kevinisabelle/litdlm01/Images/20180725_194641.jpg

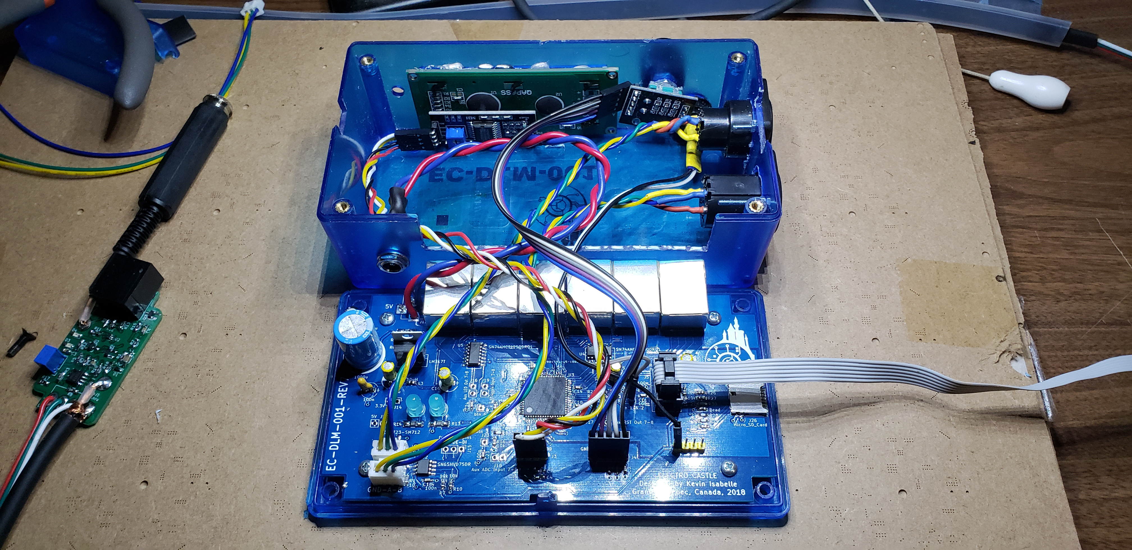
Images/20180725_194641.jpg
