kevinisabelle/litdlm01/Images/20180725_194719.jpg

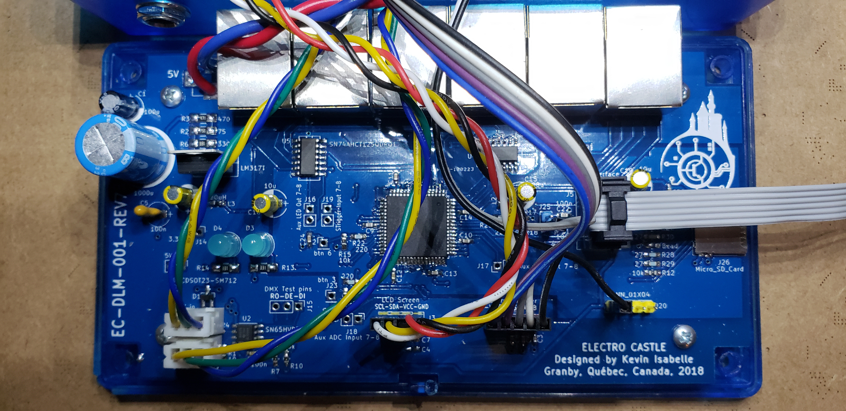
Images/20180725_194719.jpg
