kevinisabelle/litdlm01/Images/20180725_194620.jpg

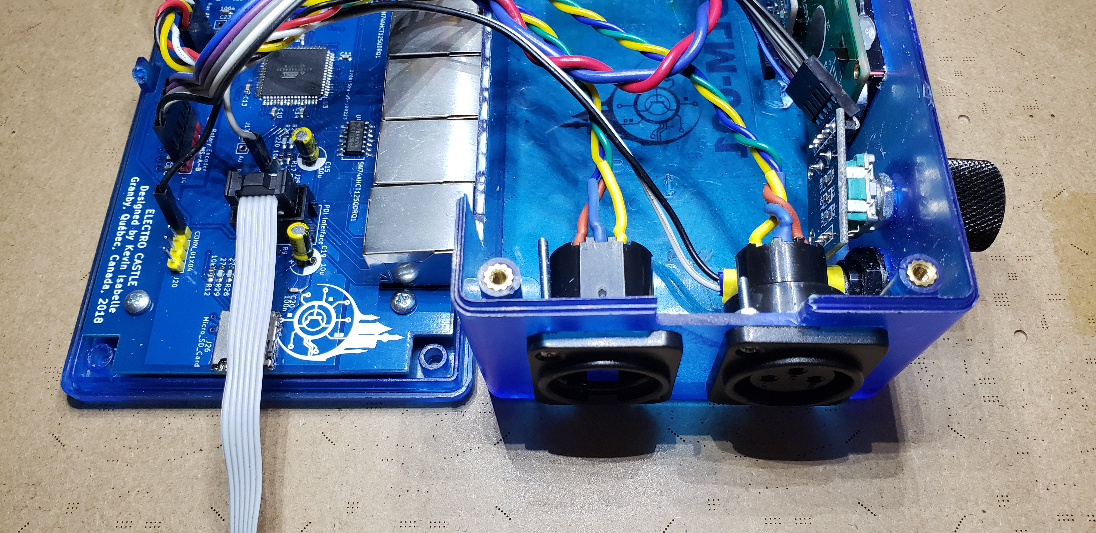
Images/20180725_194620.jpg
