kevinisabelle/litdlm01/Images/20180725_194701.jpg

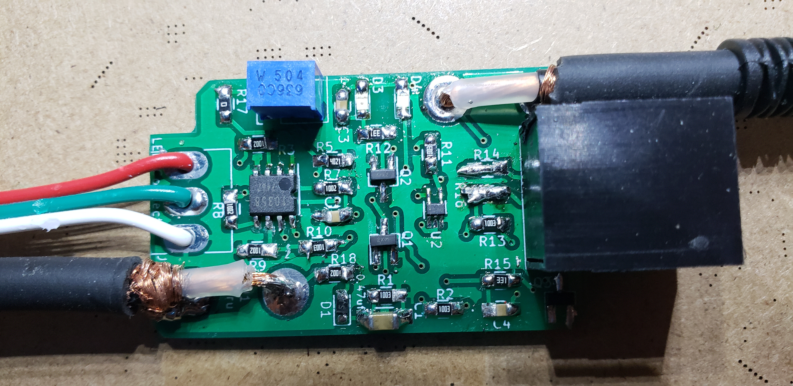
Images/20180725_194701.jpg
