kevinisabelle/litdlm01/PCBs/EC-DLM-TR03/ec-dlm-tr03-REV7.1-Front.jpg

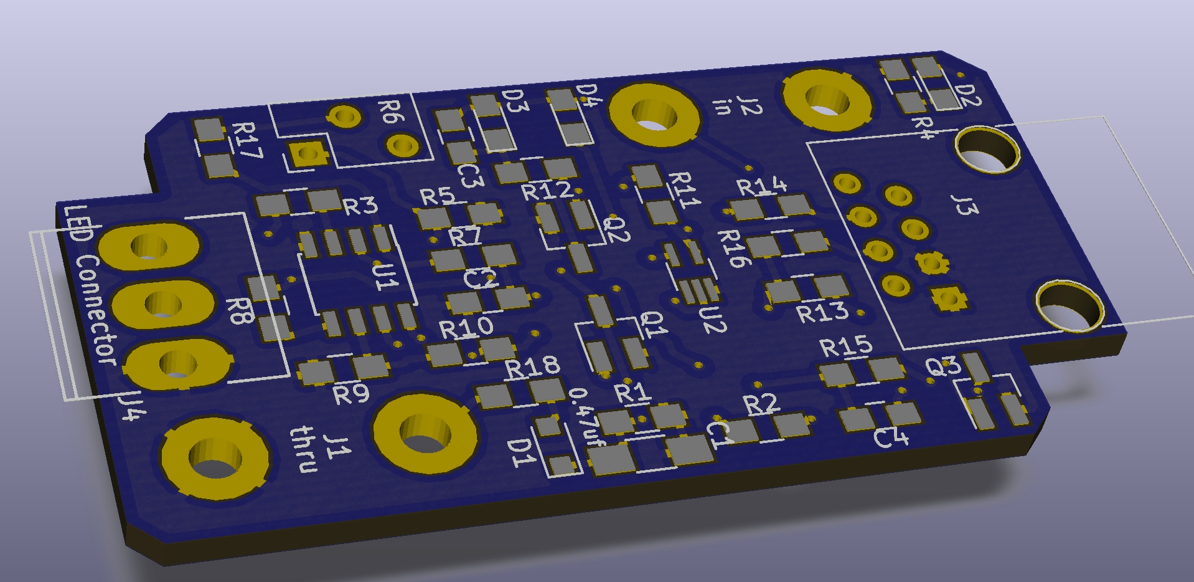
PCBs/EC-DLM-TR03/ec-dlm-tr03-REV7.1-Front.jpg
