kevinisabelle/litdlm01/PCBs/EC-DLM-TR03/ec-dlm-tr03-rev7.1-BOM.xls

 | Ref | Value | Footprint
3 | C2 | 104 | Capacitors_SMD:C_0805_HandSoldering
 | C3 | 104 | Capacitors_SMD:C_0805_HandSoldering
 | C4 | 104 | Capacitors_SMD:C_0805_HandSoldering
1 | C1 | 0.47uf | Capacitors_SMD:C_1206_HandSoldering
1 | D1 | 1N5817 | Diodes_SMD:D_SOD-323_HandSoldering
1 | U1 | ADA4075 | Housings_SOIC:SOIC-8_3.9x4.9mm_Pitch1.27mm
1 | D2 | LED (vert à l'intérieur) | LEDs:LED_0805_HandSoldering
1 | D3 | LED (vert à l'intérieur) | LEDs:LED_0805_HandSoldering
1 | D4 | LED (vert à l'intérieur) | LEDs:LED_0805_HandSoldering
3 | R14 | 0 | Resistors_SMD:R_0805_HandSoldering
 | R16 | 0 | Resistors_SMD:R_0805_HandSoldering
6 | R17 | 100k | Resistors_SMD:R_0805_HandSoldering
 | R1 | 100k | Resistors_SMD:R_0805_HandSoldering
 | R10 | 100k | Resistors_SMD:R_0805_HandSoldering
 | R11 | 100k | Resistors_SMD:R_0805_HandSoldering
 | R13 | 100k | Resistors_SMD:R_0805_HandSoldering
 | R2 | 100k | Resistors_SMD:R_0805_HandSoldering
4 | R18 | 10k | Resistors_SMD:R_0805_HandSoldering
 | R7 | 10k | Resistors_SMD:R_0805_HandSoldering
 | R8 | 10k | Resistors_SMD:R_0805_HandSoldering
 | R9 | 10k | Resistors_SMD:R_0805_HandSoldering
4 | R12 | 330 | Resistors_SMD:R_0805_HandSoldering
 | R15 | 330 | Resistors_SMD:R_0805_HandSoldering
 | R3 | 330 | Resistors_SMD:R_0805_HandSoldering
 | R4 | 330 | Resistors_SMD:R_0805_HandSoldering
1 | R5 | 4k | Resistors_SMD:R_0805_HandSoldering
3 | Q1 | 2N4401 | TO_SOT_Packages_SMD:SOT-23_Handsoldering
 | Q2 | 2N4401 | TO_SOT_Packages_SMD:SOT-23_Handsoldering
 | Q3 | 2N4401 | TO_SOT_Packages_SMD:SOT-23_Handsoldering
1 | U2 | SN74LVC1G17-Q1 | TO_SOT_Packages_SMD:SOT-353_SC-70-5_Handsoldering
 | J2 | in | Wire_Connections_Bridges:WireConnection_2.50mmDrill
 | J1 | thru | Wire_Connections_Bridges:WireConnection_2.50mmDrill
 | J3 | RJ45 | Connectors:RJ45_8
 | R6 | 500k | ec-dlm:TrimPot_Straight_2x03_Pitch2.54mm
 | J4 | LED Connector | 3 wires with connector
