kevinisabelle/litdlm01/PCBs/EC-DLM-TR04/ec-dlm-tr04-bom.ods

 | Reference | Value | Footprint | Datasheet
3 | C4 | 0.1uf | Capacitors_SMD:C_0805_HandSoldering
 | C6 | 0.1uf | Capacitors_SMD:C_0805_HandSoldering
 | C7 | 0.1uf | Capacitors_SMD:C_0805_HandSoldering
3 | C2 | 100uf | Capacitors_THT:CP_Radial_D4.0mm_P1.50mm
 | C3 | 100uf | Capacitors_THT:CP_Radial_D4.0mm_P1.50mm
 | C5 | 100uf | Capacitors_THT:CP_Radial_D4.0mm_P1.50mm
1 | C1 | 330uf | Capacitors_THT:CP_Radial_D4.0mm_P1.50mm
1 | J2 | RJ45 | Connectors:RJ45_8
7 | D1 | 1N4148 | Diodes_SMD:D_SOD-123
 | D6 | 1N4148 | Diodes_SMD:D_SOD-123
 | D8 | 1N4148 | Diodes_SMD:D_SOD-123
 | D2 | 1N4148 | Diodes_SMD:D_SOD-123
 | D3 | 1N4148 | Diodes_SMD:D_SOD-123
 | D4 | 1N4148 | Diodes_SMD:D_SOD-123
 | D5 | 1N4148 | Diodes_SMD:D_SOD-123
2 | D7 | BZX79C3V3 | Diodes_THT:D_DO-35_SOD27_P2.54mm_Vertical_AnodeUp
 | D9 | BZX79C3V3 | Diodes_THT:D_DO-35_SOD27_P2.54mm_Vertical_AnodeUp
1 | RV1 | 10k | Potentiometers:Potentiometer_WirePads_Small
1 | RV2 | 5k | Potentiometers:Potentiometer_WirePads_Small
1 | R17 | 100k | Resistors_SMD:R_0603_HandSoldering
5 | R12 | 10k | Resistors_SMD:R_0603_HandSoldering
 | R16 | 10k | Resistors_SMD:R_0603_HandSoldering
 | R5 | 10k | Resistors_SMD:R_0603_HandSoldering
 | R6 | 10k | Resistors_SMD:R_0603_HandSoldering
 | R7 | 10k | Resistors_SMD:R_0603_HandSoldering
1 | R1 | 10m | Resistors_SMD:R_0603_HandSoldering
2 | R13 | 15k | Resistors_SMD:R_0603_HandSoldering
 | R3 | 15k | Resistors_SMD:R_0603_HandSoldering
1 | R2 | 1m | Resistors_SMD:R_0603_HandSoldering
2 | R10 | 20k | Resistors_SMD:R_0603_HandSoldering
 | R8 | 20k | Resistors_SMD:R_0603_HandSoldering
1 | R11 | 3.9k | Resistors_SMD:R_0603_HandSoldering
1 | R4 | 6.6k | Resistors_SMD:R_0603_HandSoldering
1 | R15 | 600 | Resistors_SMD:R_0603_HandSoldering
1 | R14 | 8k | Resistors_SMD:R_0603_HandSoldering
1 | R9 | 9k | Resistors_SMD:R_0603_HandSoldering
2 | U1 | TL084 | SMD_Packages:SOIC-14_N
 | U3 | TL084 | SMD_Packages:SOIC-14_N
 | J3 | LED Connector | Sockets_MOLEX_KK-System:Socket_MOLEX-KK-RM3-96mm_Lock_3pin_straight
 | J1 | input | Wire_Connections_Bridges:WireConnection_2.50mmDrill
