kevinisabelle/litdlm01/PCBs/EC-DLM-001-Rev9/kicadProject/EC-DLM-001-Rev9-bom.csv

Reference | Value | Footprint | Datasheet
U3 | ATXMEGA64A3U-AU | Housings_QFP:TQFP-64_14x14mm_Pitch0.8mm
C9 | 100n | Capacitors_SMD:C_0805_HandSoldering
C10 | 100n | Capacitors_SMD:C_0805_HandSoldering
C11 | 100n | Capacitors_SMD:C_0805_HandSoldering
C12 | 100n | Capacitors_SMD:C_0805_HandSoldering
C13 | 100n | Capacitors_SMD:C_0805_HandSoldering
C14 | 100n | Capacitors_SMD:C_0805_HandSoldering
J9 | RJ45 | Connectors:RJ45_8
J11 | RJ45 | Connectors:RJ45_8
J8 | RJ45 | Connectors:RJ45_8
J10 | RJ45 | Connectors:RJ45_8
L2 | Fer Bead | Inductors_SMD:L_0805_HandSoldering
U2 | SN65HVD75DR | Housings_SOIC:SOIC-8_3.9x4.9mm_Pitch1.27mm
U1 | LM317T | TO_SOT_Packages_THT:TO-220-3_Vertical
C1 | 100u | Capacitors_THT:CP_Radial_D6.3mm_P2.50mm
C2 | 10u-tant | Capacitors_THT:CP_Radial_D6.3mm_P2.50mm
C5 | 100n | Capacitors_THT:CP_Radial_Tantal_D5.5mm_P2.50mm
R2 | 75 | Resistors_SMD:R_1206_HandSoldering
R3 | 470 | Resistors_SMD:R_1206_HandSoldering
R6 | 330 | Resistors_SMD:R_1206_HandSoldering
J5 | PDI Interface | Connectors:IDC_Header_Straight_6pins
L3 | 10uH | Inductors_SMD:L_0805_HandSoldering
C16 | 10u-tant | Capacitors_THT:CP_Radial_D6.3mm_P2.50mm
C15 | 10u | Capacitors_THT:CP_Radial_D6.3mm_P2.50mm
R9 | 10K | Resistors_SMD:R_0805_HandSoldering
R7 | 10k | Resistors_SMD:R_0805_HandSoldering
R10 | 10k | Resistors_SMD:R_0805_HandSoldering
J2 | DMX in | Pin_Headers:Pin_Header_Straight_1x03_Pitch2.54mm
J1 | DMX out | Pin_Headers:Pin_Header_Straight_1x03_Pitch2.54mm
J4 | Rotary Encoder | Pin_Headers:Pin_Header_Straight_1x05_Pitch2.54mm
J3 | LCD Screen | Pin_Headers:Pin_Header_Straight_1x04_Pitch2.54mm
C8 | 100n | Capacitors_SMD:C_0805_HandSoldering
C6 | 100n | Capacitors_SMD:C_0805_HandSoldering
C3 | 100n | Capacitors_SMD:C_0805_HandSoldering
J12 | BARREL_JACK | Connectors:BARREL_JACK
J15 | DMX Test pins | Pin_Headers:Pin_Header_Straight_1x03_Pitch2.54mm
C17 | 1000u | Capacitors_THT:CP_Radial_D13.0mm_P5.00mm
D4 | LED | LEDs:LED_D5.0mm
R14 | R | Resistors_SMD:R_1206_HandSoldering
R13 | R | Resistors_SMD:R_1206_HandSoldering
D3 | LED | LEDs:LED_D5.0mm
U4 | SN74AHCT125QDRQ1 | SMD_Packages:SOIC-14_N
U5 | SN74AHCT125QDRQ1 | SMD_Packages:SOIC-14_N
R1 | 10 | Resistors_SMD:R_0805_HandSoldering
R4 | 10 | Resistors_SMD:R_0805_HandSoldering
C18 | 100n | Capacitors_SMD:C_0805_HandSoldering
D1 | CDSOT23-SM712 | TO_SOT_Packages_SMD:SOT-23_Handsoldering
J25 | btn 1 & 2 | Pin_Headers:Pin_Header_Straight_1x02_Pitch2.54mm
R24 | 220 | Resistors_SMD:R_0805_HandSoldering
R25 | 220 | Resistors_SMD:R_0805_HandSoldering
R17 | 10k | Resistors_SMD:R_0805_HandSoldering
R18 | 10k | Resistors_SMD:R_0805_HandSoldering
J20 | BTN-VDD | Pin_Headers:Pin_Header_Straight_1x04_Pitch2.54mm
C22 | 100n | Capacitors_SMD:C_0805_HandSoldering
C21 | 100n | Capacitors_SMD:C_0805_HandSoldering
J6 | RJ45 | Connectors:RJ45_8
J7 | RJ45 | Connectors:RJ45_8
F1 | Fuse | Fuse_Holders_and_Fuses:Fuseholder5x20_horiz_open_lateral_Type-II
L4 | 100uH | Inductors_THT:L_Radial_D9.5mm_P5.00mm_Fastron_07HVP
J13 | Bluetooth Module | Pin_Headers:Pin_Header_Straight_1x06_Pitch2.54mm
L5 | 10uH | Inductors_THT:L_Axial_L9.5mm_D4.0mm_P5.08mm_Vertical_Fastron_SMCC
D2 | 1N5821 | Diodes_THT:D_DO-201AD_P15.24mm_Horizontal
C4 | 0.33u | Capacitors_THT:CP_Radial_D5.0mm_P2.50mm
R11 | 2k | Resistors_THT:R_Axial_DIN0207_L6.3mm_D2.5mm_P10.16mm_Horizontal
C19 | 680u | Capacitors_THT:CP_Radial_D13.0mm_P7.50mm
R8 | 2.2k | Resistors_THT:R_Axial_DIN0207_L6.3mm_D2.5mm_P10.16mm_Horizontal
R5 | 17.3k | Resistors_THT:R_Axial_DIN0207_L6.3mm_D2.5mm_P10.16mm_Horizontal
C7 | 0.1u | Capacitors_THT:CP_Radial_D5.0mm_P2.50mm
C20 | 100n | Capacitors_THT:CP_Radial_D6.3mm_P2.50mm
C23 | 100n | Capacitors_THT:CP_Radial_D6.3mm_P2.50mm
U6 | LM2577 | TO_SOT_Packages_THT:TO-220-5_Vertical
C25 | 100n | Capacitors_THT:CP_Radial_D6.3mm_P2.50mm
C26 | 100n | Capacitors_THT:CP_Radial_D6.3mm_P2.50mm
C28 | 100n | Capacitors_THT:CP_Radial_D6.3mm_P2.50mm
C29 | 100n | Capacitors_THT:CP_Radial_D6.3mm_P2.50mm
C27 | 100n | Capacitors_THT:CP_Radial_D6.3mm_P2.50mm
C30 | 100n | Capacitors_THT:CP_Radial_D6.3mm_P2.50mm
C24 | 100n | Capacitors_THT:CP_Radial_D6.3mm_P2.50mm
