kevinisabelle/litdlm01/Doc/BuildCost.xlsx

Build Details
Part | Desc | QTY | Unit cost | Total | Inventaire | Link
Main unit | Main PCB for the module + BOM + CASE | 1 | 42.00 $ | 42.00 $ | 10 | BOM (http://192.168.1.21:8081/display/EC/BOM)
Trigger units | Small PCB for trigger + BOM + CASE | 6 | 9.00 $ | 54.00 $ | 40 | BOM - Trigger Module (http://192.168.1.21:8081/display/EC/BOM+-+Trigger+Module)
LEDs WS2812b | 6 * 30 LEDs = 180 | 180 | 0.09 $ | 16.20 $ | 700 | Amazon / 0.09 par pixel: Ali
XLR Connector | DMX in / out | 2 | 1.00 $ | 2.00 $ | 15 | Digikey Ali
I2C LCD | Main screen | 1 | 1.80 $ | 1.80 $ | 20 | Ali / 1,80 sur ali (https://fr.aliexpress.com/item/IIC-I2C-1602-Serial-Blue-Backlight-LCD-Display-ForArduino-2560-UNO-AVR-A004/1948246379.html)
Rotary encoder | Main control | 1 | 0.55 $ | 0.55 $ | 6 | Ali
Buttons | Main buttons | 4 | 2.00 $ | 8.00 $
Network cable | To connect trigger modules to main module | 6 | 1.95 $ | 11.70 $ | 50 | Ali / 1,95 sur ali (https://www.aliexpress.com/item/2M-CAT6-UTP-flat-network-cable-GigE-Ethernet-cable-gold-plate-crystal-head-8P8C-RJ45-connecter/32476220523.html)
5V 10A Power supply | Main power supply for the unit | 1 | 13.99 $ | 13.99 $ | 4 | Amazon / 13,99: Ali
Misc glue and solder |  | 1 | 2.00 $ | 2.00 $ | ok / ok
Misc connectors and pins |  | 1 | 2.00 $ | 2.00 $ | ok / ok
Misc connection wires |  | 1 | 2.00 $ | 2.00 $ | ok / ok
Misc part shipping |  | 1 | 3.00 $ | 3.00 $
Box for packaging |  | 1 | 1.00 $ | 1.00 $ | 0 | Uline (https://fr.uline.ca/Product/Detail/S-13293/Corrugated-Boxes-200-Test/12-x-7-x-5-Corrugated-Boxes)
Bags for parts |  | 10 | 0.10 $ | 1.00 $ | 0 | Uline
Sticker for shipping box |  | 1 | 4.00 $ | 4.00 $ | 0 | Vistaprint
User manual print |  | 1 | 2.00 $ | 2.00 $
Total |  |  |  | 167.24 $
Assembly time / Test |  | 4 | 25 | 100.00 $
Cost w/ assembly |  |  |  | 267.24 $
Suggested sale price |  |  |  | 499.99 $ | 1.87
Profitable 250% |  |  |  | 668.10 $ | ( X 2.5)
