kevinisabelle/litdlm01/PCBs/EC-DLM-001-Rev9/kicadProject/EC-DLM-001-Rev9.ods

 |  | Reference | Value | Footprint | Datasheet
13 | 1 | C10 | 100n | Capacitors_SMD:C_0805_HandSoldering
 | 1 | C11 | 100n | Capacitors_SMD:C_0805_HandSoldering
 | 1 | C12 | 100n | Capacitors_SMD:C_0805_HandSoldering
 | 1 | C13 | 100n | Capacitors_SMD:C_0805_HandSoldering
 | 1 | C14 | 100n | Capacitors_SMD:C_0805_HandSoldering
 | 1 | C18 | 100n | Capacitors_SMD:C_0805_HandSoldering
 | 1 | C19 | 100n | Capacitors_SMD:C_0805_HandSoldering
 | 1 | C21 | 100n | Capacitors_SMD:C_0805_HandSoldering
 | 1 | C22 | 100n | Capacitors_SMD:C_0805_HandSoldering
 | 1 | C3 | 100n | Capacitors_SMD:C_0805_HandSoldering
 | 1 | C6 | 100n | Capacitors_SMD:C_0805_HandSoldering
 | 1 | C8 | 100n | Capacitors_SMD:C_0805_HandSoldering
 | 1 | C9 | 100n | Capacitors_SMD:C_0805_HandSoldering
1 | 1 | C4 | 22u | Capacitors_SMD:C_0805_HandSoldering
1 | 1 | C7 | 39p | Capacitors_SMD:C_0805_HandSoldering
1 | 1 | C20 | 68u | Capacitors_SMD:C_0805_HandSoldering
1 | 1 | C17 | 1000u | Capacitors_THT:CP_Radial_D13.0mm_P5.00mm
1 | 1 | C1 | 100u | Capacitors_THT:CP_Radial_D6.3mm_P2.50mm
3 | 1 | C15 | 10u | Capacitors_THT:CP_Radial_D6.3mm_P2.50mm
 | 1 | C16 | 10u | Capacitors_THT:CP_Radial_D6.3mm_P2.50mm
 | 1 | C2 | 10u | Capacitors_THT:CP_Radial_D6.3mm_P2.50mm
1 | 1 | C5 | 100n | Capacitors_THT:CP_Radial_Tantal_D5.5mm_P2.50mm
1 | 1 | J12 | BARREL_JACK | Connectors:BARREL_JACK
1 | 1 | J5 | PDI Interface | Connectors:IDC_Header_Straight_6pins
6 | 1 | J10 | RJ45 | Connectors:RJ45_8
 | 1 | J11 | RJ45 | Connectors:RJ45_8
 | 1 | J6 | RJ45 | Connectors:RJ45_8
 | 1 | J7 | RJ45 | Connectors:RJ45_8
 | 1 | J8 | RJ45 | Connectors:RJ45_8
 | 1 | J9 | RJ45 | Connectors:RJ45_8
1 | 1 | D2 | D_Schottky | Diodes_THT:D_A-405_P5.08mm_Vertical_AnodeUp
1 | 1 | F1 | Fuse | Fuse_Holders_and_Fuses:Fuseholder5x20_horiz_open_lateral_Type-II
1 | 1 | U3 | ATXMEGA192A3U-AU | Housings_QFP:TQFP-64_14x14mm_Pitch0.8mm
1 | 1 | U2 | SN65HVD75DR | Housings_SOIC:SOIC-8_3.9x4.9mm_Pitch1.27mm
1 | 1 | U6 | LM2621 | Housings_SSOP:VSSOP-8_3.0x3.0mm_Pitch0.65mm
2 | 1 | L3 | 10uH | Inductors_SMD:L_0805_HandSoldering
 | 1 | L5 | 10uH | Inductors_SMD:L_0805_HandSoldering
1 | 1 | L4 | 6.8uH | Inductors_SMD:L_0805_HandSoldering
1 | 1 | L2 | Fer Bead | Inductors_SMD:L_0805_HandSoldering
2 | 1 | D3 | LED | LEDs:LED_D5.0mm
 | 1 | D4 | LED | LEDs:LED_D5.0mm
30 | 1 | J25 | btn 1 & 2 | Pin_Headers:Pin_Header_Straight_1x02_Pitch2.54mm
 | 1 | J2 | DMX in | Pin_Headers:Pin_Header_Straight_1x03_Pitch2.54mm
 | 1 | J1 | DMX out | Pin_Headers:Pin_Header_Straight_1x03_Pitch2.54mm
 | 1 | J15 | DMX Test pins | Pin_Headers:Pin_Header_Straight_1x03_Pitch2.54mm
 | 1 | J20 | BTN-VDD | Pin_Headers:Pin_Header_Straight_1x04_Pitch2.54mm
 | 1 | J3 | LCD Screen | Pin_Headers:Pin_Header_Straight_1x04_Pitch2.54mm
 | 1 | J4 | Rotary Encoder | Pin_Headers:Pin_Header_Straight_1x05_Pitch2.54mm
 | 1 | J13 | Bluetooth Module | Pin_Headers:Pin_Header_Straight_1x06_Pitch2.54mm
2 | 1 | R1 | 10 | Resistors_SMD:R_0805_HandSoldering
 | 1 | R4 | 10 | Resistors_SMD:R_0805_HandSoldering
5 | 1 | R10 | 10k | Resistors_SMD:R_0805_HandSoldering
 | 1 | R17 | 10k | Resistors_SMD:R_0805_HandSoldering
 | 1 | R18 | 10k | Resistors_SMD:R_0805_HandSoldering
 | 1 | R7 | 10k | Resistors_SMD:R_0805_HandSoldering
 | 1 | R9 | 10K | Resistors_SMD:R_0805_HandSoldering
1 | 1 | R8 | 150k | Resistors_SMD:R_0805_HandSoldering
1 | 1 | R5 | 17.3k | Resistors_SMD:R_0805_HandSoldering
1 | 1 | R11 | 200k | Resistors_SMD:R_0805_HandSoldering
2 | 1 | R24 | 220 | Resistors_SMD:R_0805_HandSoldering
 | 1 | R25 | 220 | Resistors_SMD:R_0805_HandSoldering
1 | 1 | R12 | 500 | Resistors_SMD:R_0805_HandSoldering
3 | 1 | R6 | 330 | Resistors_SMD:R_1206_HandSoldering
1 | 1 | R3 | 470 | Resistors_SMD:R_1206_HandSoldering
1 | 1 | R2 | 75 | Resistors_SMD:R_1206_HandSoldering
 | 1 | R13 | 330 | Resistors_SMD:R_1206_HandSoldering
 | 1 | R14 | 330 | Resistors_SMD:R_1206_HandSoldering
2 | 1 | U4 | SN74AHCT125QDRQ1 | SMD_Packages:SOIC-14_N
 | 1 | U5 | SN74AHCT125QDRQ1 | SMD_Packages:SOIC-14_N
1 | 1 | D1 | CDSOT23-SM712 | TO_SOT_Packages_SMD:SOT-23_Handsoldering
1 | 1 | U1 | LM317T | TO_SOT_Packages_THT:TO-220-3_Vertical
