kevinisabelle/litdlm01/PCBs/EC-DLM-001-Rev9/EC-DLM-001-Rev9.pdf

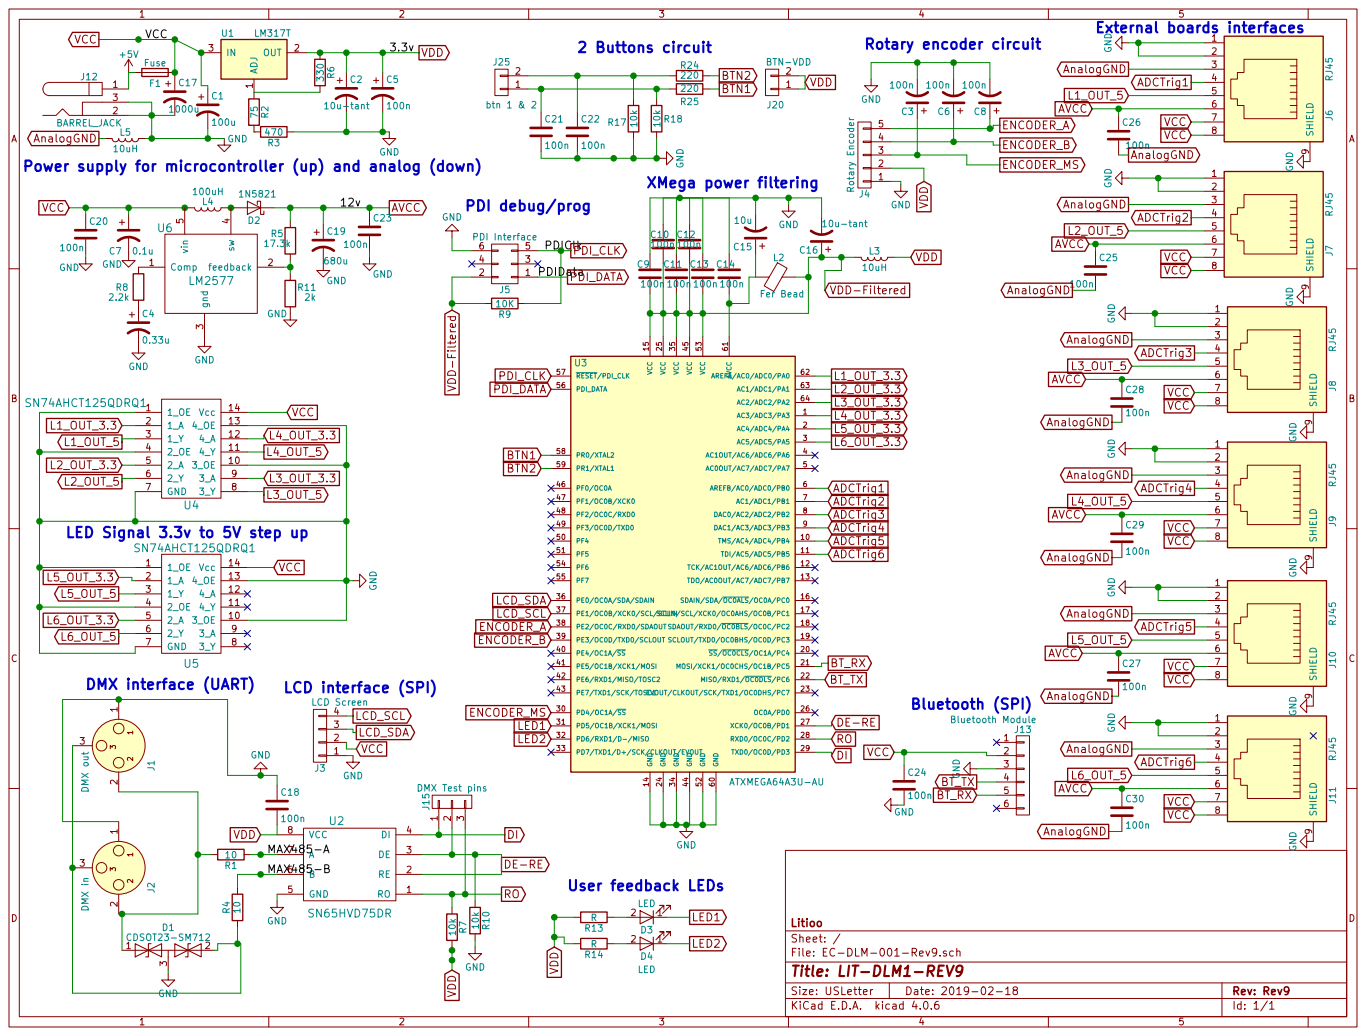
[picture p9: page 1]

AnalogGND
Power supply for microcontroller (up) and analog (down)

LED Signal 3.3v to 5V step up

File: EC-DLM-001-Rev9.sch Sheet: / Litioo
