kevinisabelle/litdlm01/PCBs/EC-DLM-TR05/ec-dlm-tr04.pdf

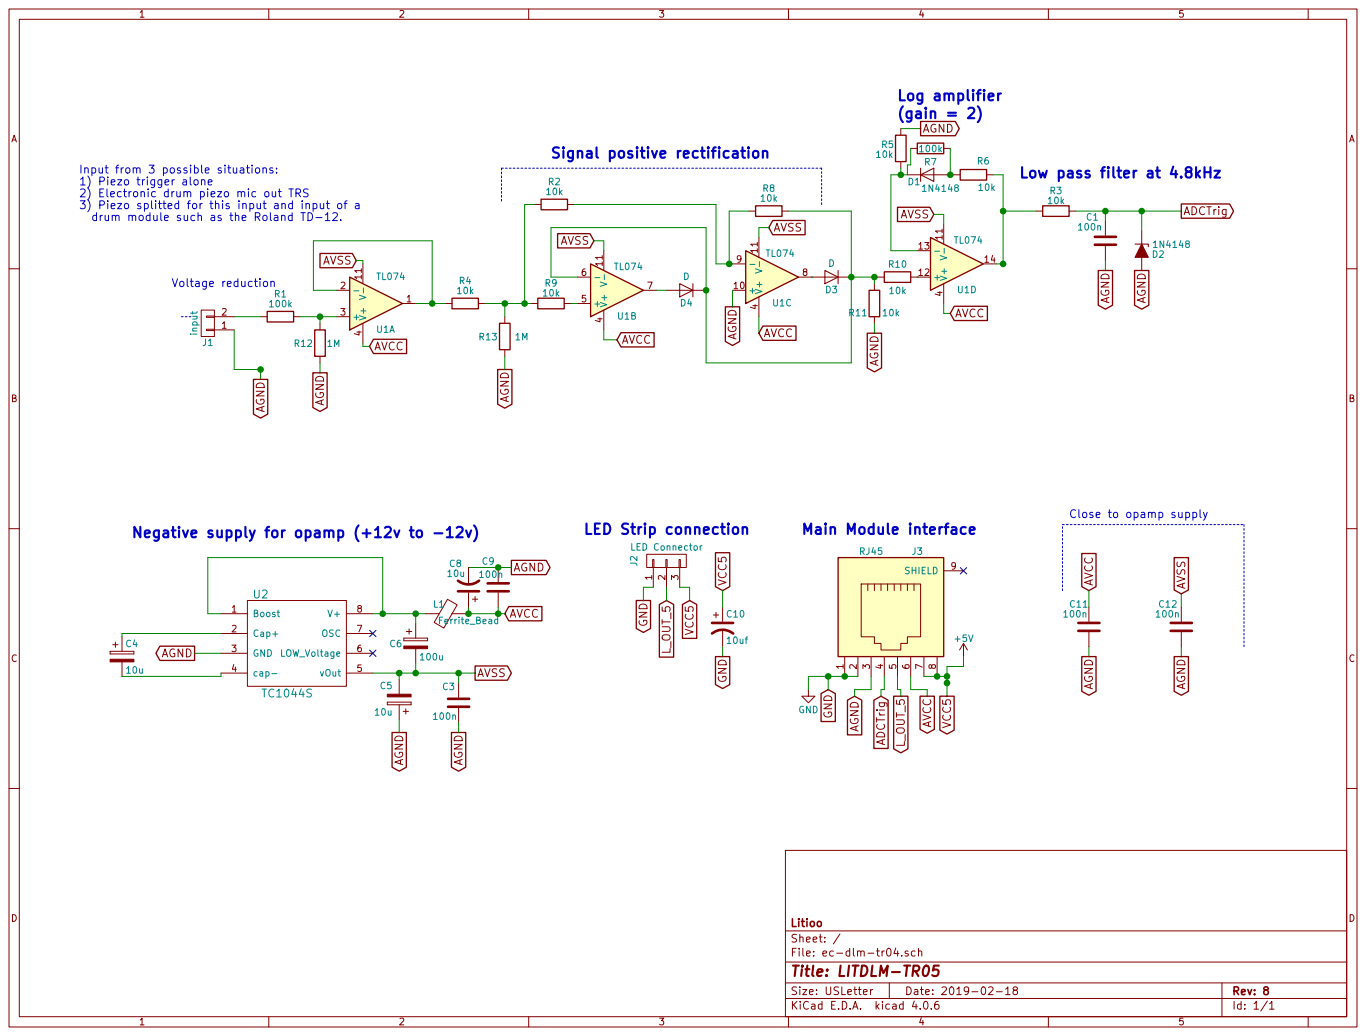
[picture p10: page 1]

Low pass filter at 4.8kHz Input from 3 possible situations:
1) Piezo trigger alone
2) Electronic drum piezo mic out TRS
3) Piezo splitted for this input and input of a

10u Negative supply for opamp (+12v to -12v) C6

File: ec-dlm-tr04.sch Sheet: / Litioo
