kevinisabelle/litdlm01/PCBs/EC-DLM-TR03/ec-dlm-tr03-rev7.1-schematic.pdf

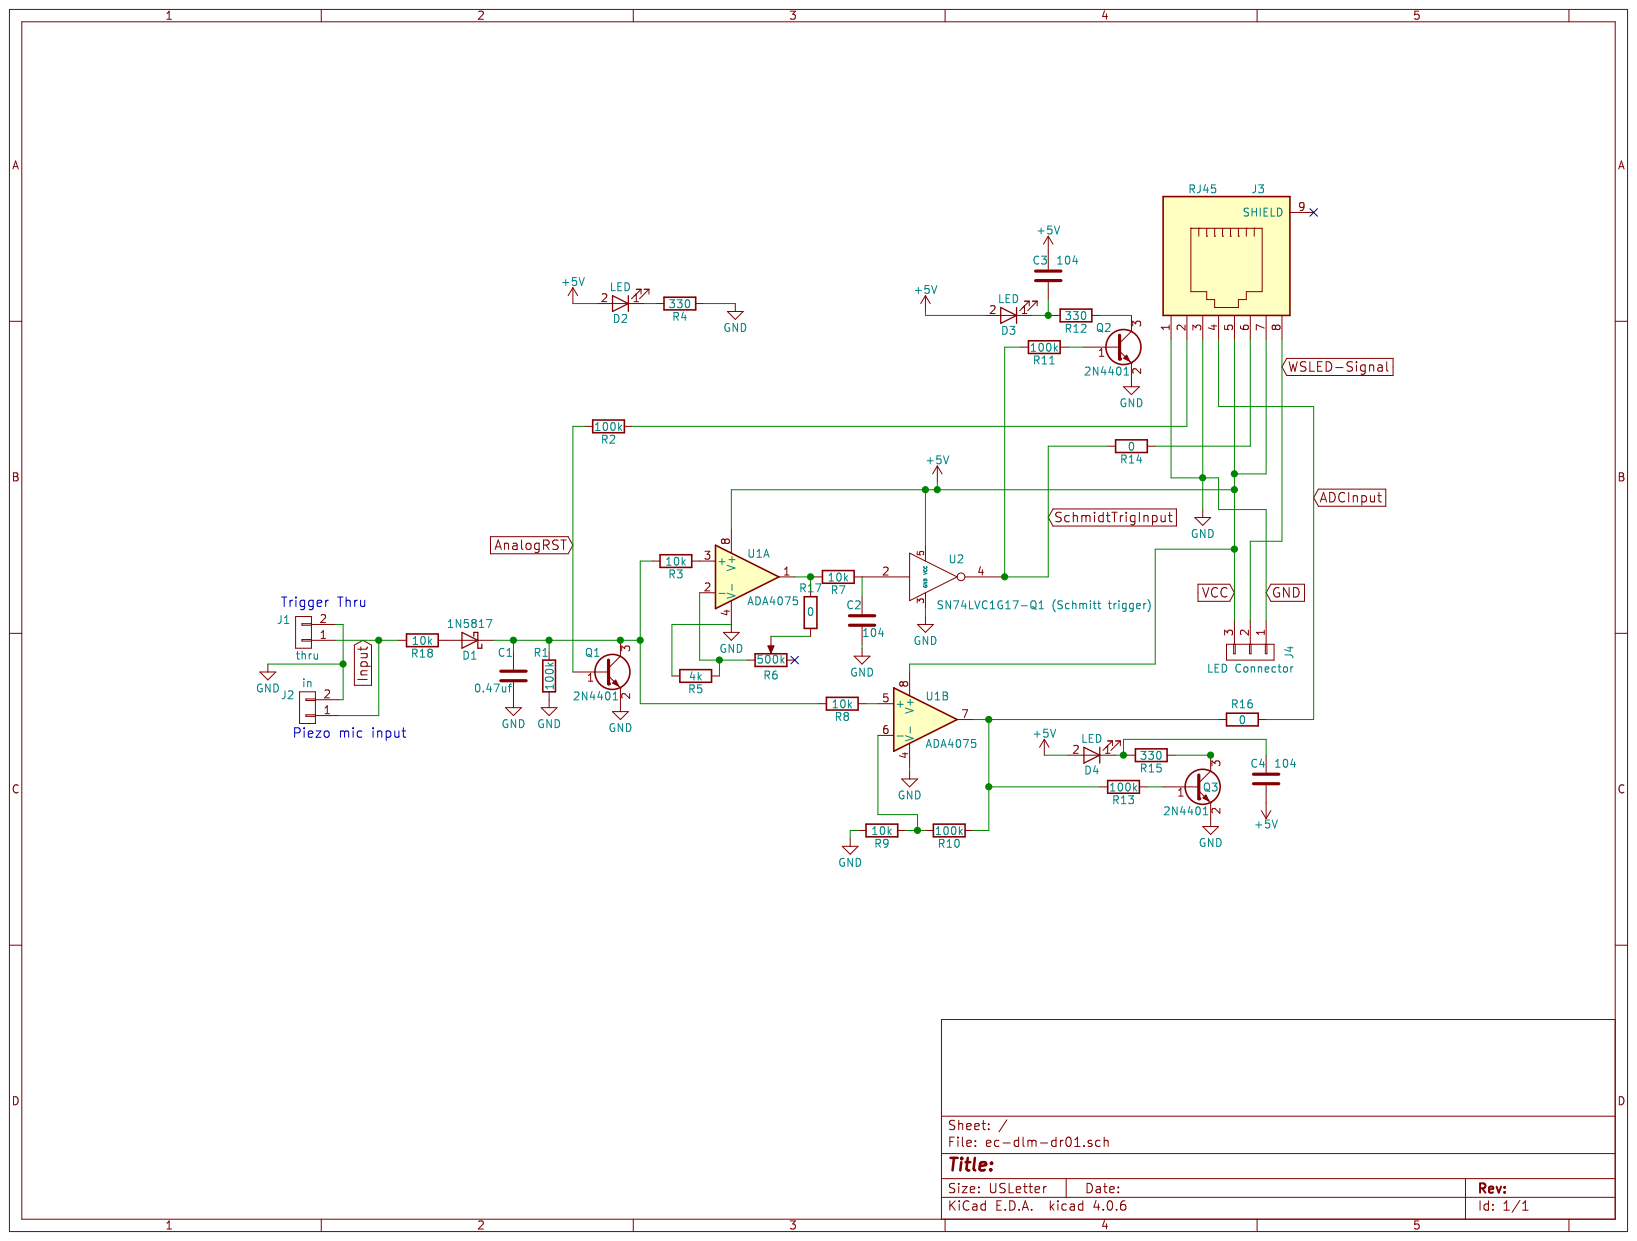
[picture p11: page 1]
