kevinisabelle/litdlm01/PCBs/EC-DLM-Enclosure/DLM-Enclosure-CutsDimensions.pdf

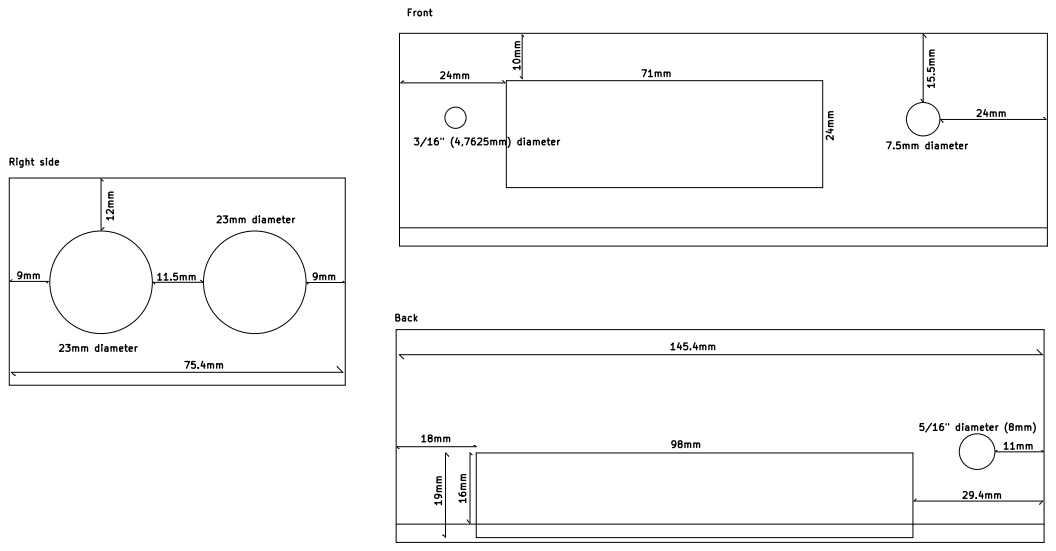
[picture p12: page 1]
