kevinisabelle/litdlm01/PCBs/EC-DLM-Enclosure/DLM-Enclosure-Edge.Cuts.pdf

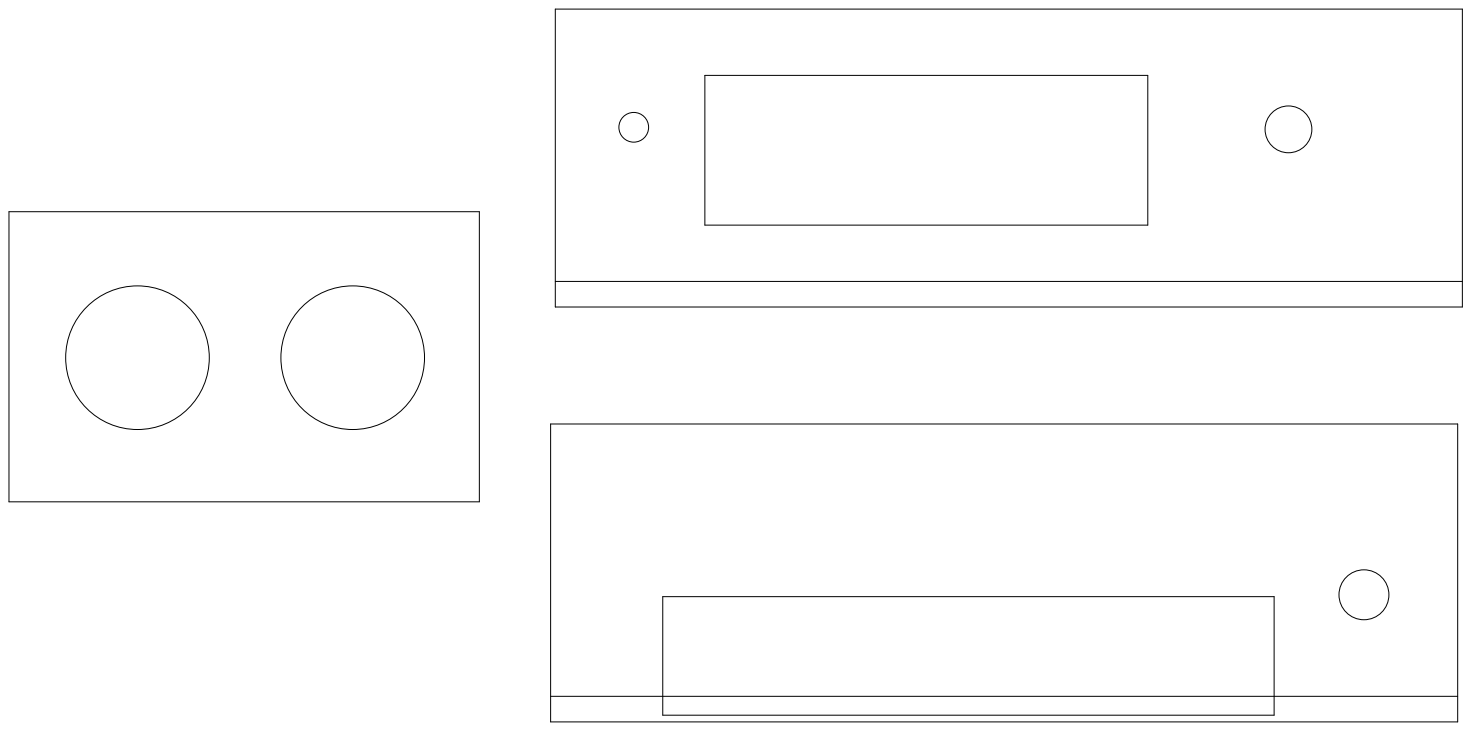
[picture p13: page 1]
