kevinisabelle/litdlm01/PCBs/Archive/EC-DLM-001-Rev7/ec-dlm-001-rev7-Schematic.pdf

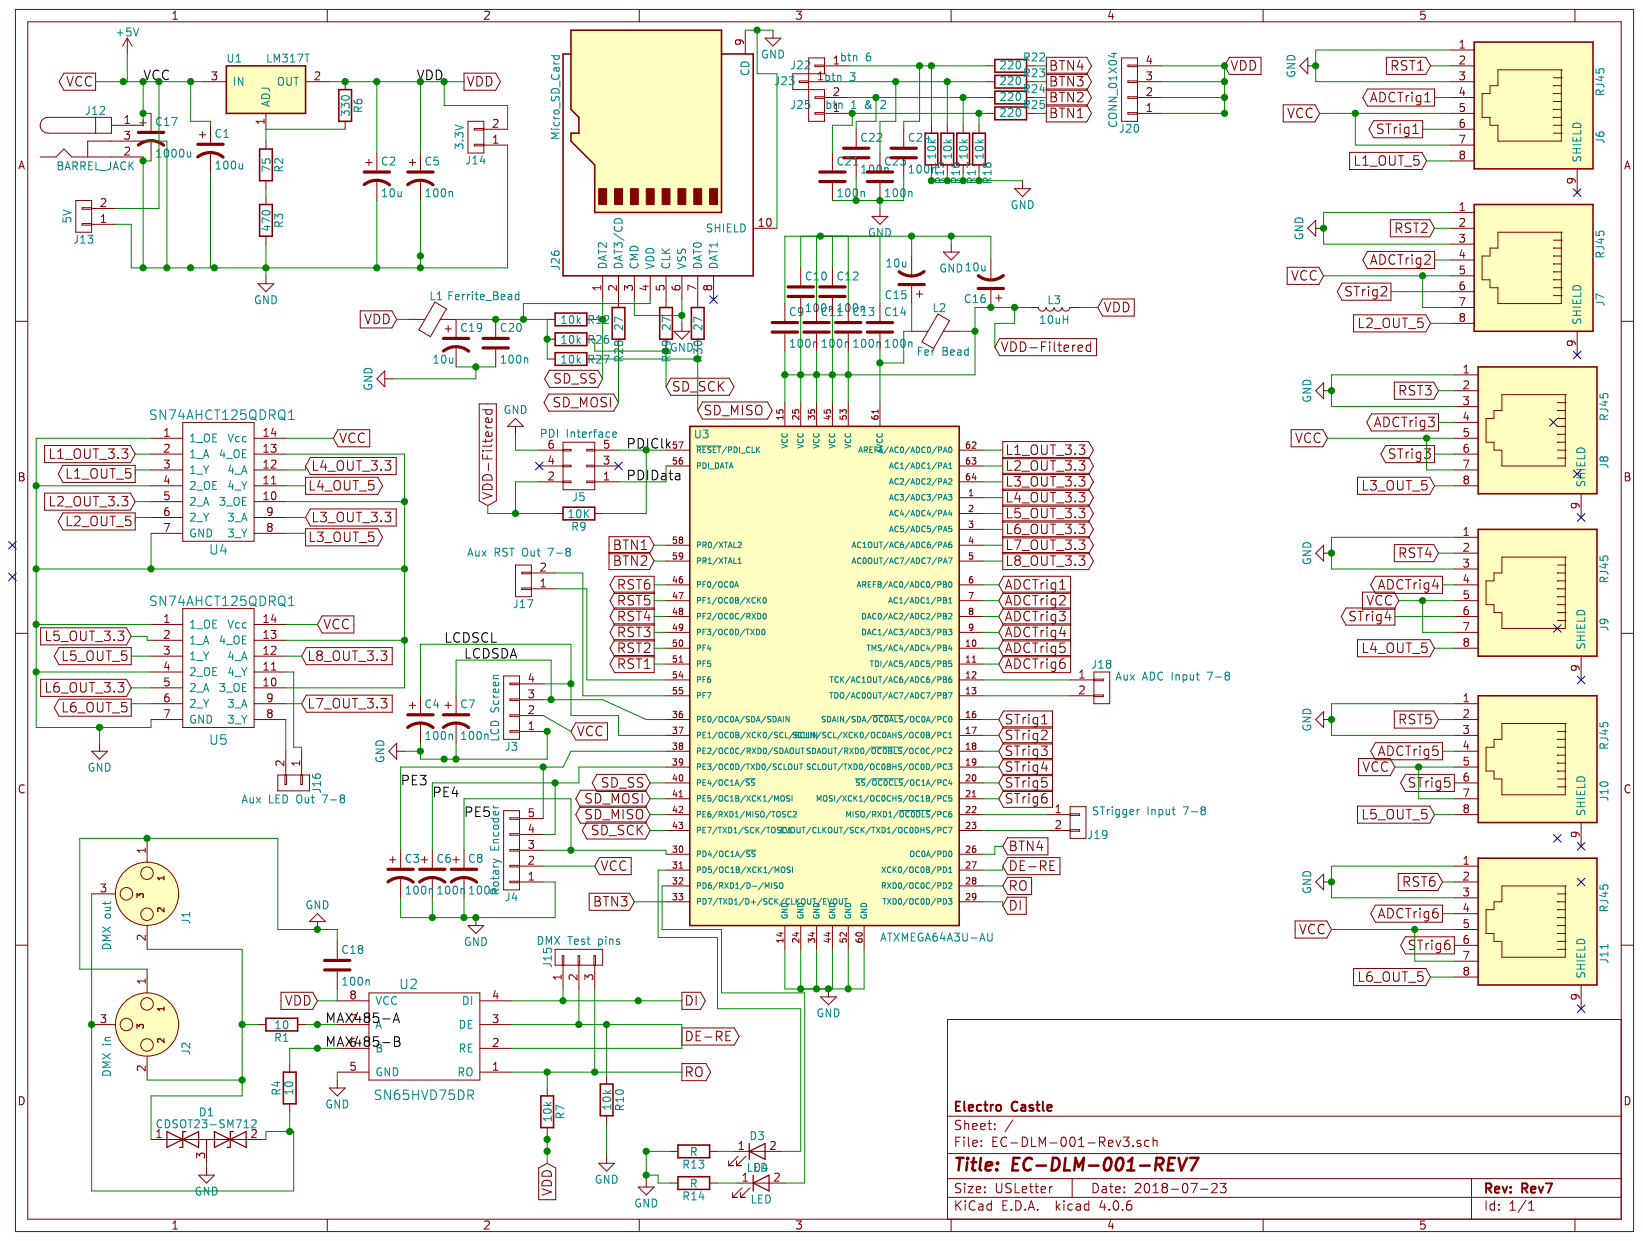
[picture p14: page 1]
