kevinisabelle/litdlm01/PCBs/EC-DLM-TR05/kicadProject/ec-dlm-tr04.kicad_pcb

## KiCad design PCBs/EC-DLM-TR05/kicadProject/ec-dlm-tr04.kicad_pcb (2024-09-17)

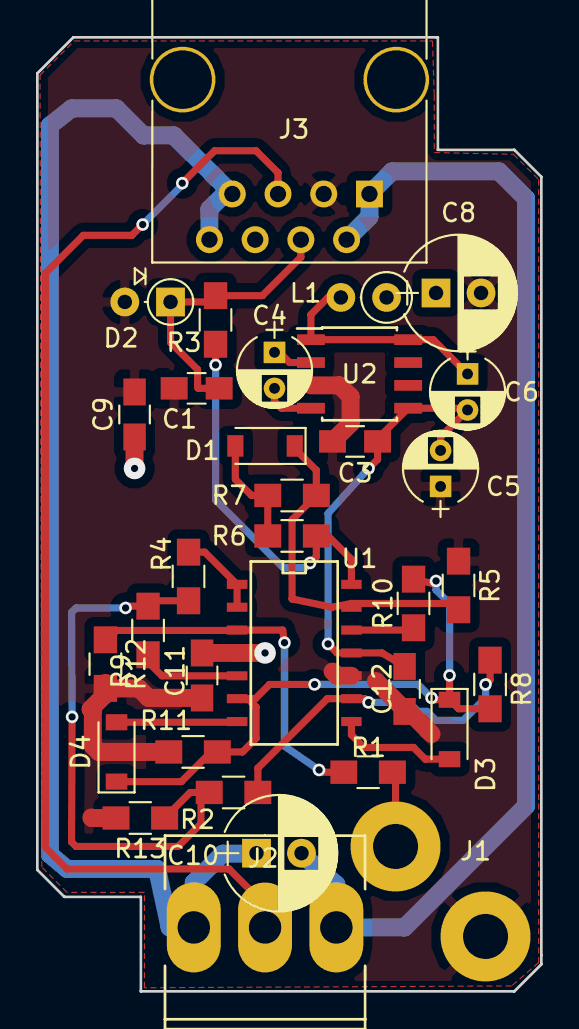
[picture p15: board ec-dlm-tr04.kicad_pcb from above]

Board: 2 copper layers, 28.0 x 53.0 mm, 33 parts (0 on the bottom side), 23 nets.

Parts:
C1, C3, C9, C11, C12: 100n; C_0805_HandSoldering
C4, C5: 10u; CP_Radial_D4.0mm_P2.00mm
C6: 100u; CP_Radial_D4.0mm_P2.00mm
C8: 10u; CP_Radial_D6.3mm_P2.50mm
C10: 10uf; CP_Radial_D6.3mm_P2.50mm
D1: 1N4148; D_SOD-123
D2: 1N4148; D_DO-35_SOD27_P2.54mm_Vertical_AnodeUp
D3, D4: D; D_SOD-123
J1: input; WireConnection_2.50mmDrill
J2: LED Connector; Socket_MOLEX-KK-RM3-96mm_Lock_3pin_straight
J3: RJ45; RJ45_8
L1: Ferrite_Bead; L_Axial_L6.6mm_D2.7mm_P2.54mm_Vertical_Vishay_IM-2
R1, R7: 100k; R_0805_HandSoldering
R2, R3, R4, R5, R6, R8, R9, R10, R11: 10k; R_0805_HandSoldering
R12, R13: 1M; R_0805_HandSoldering
U1: TL074; SOIC-14_N
U2: TC1044S; SOIC-8_3.9x4.9mm_Pitch1.27mm

Connections:
ADCTrig: C1.2, D2.1, J3.4, R3.2
AGND: C1.1, C3.2, C5.1, C8.2, C9.1, C11.2, C12.2, D2.2, J1.1, J3.3, R5.2, R11.1, R12.2, R13.2, U1.10, U2.3
AVCC: C8.1, C9.2, C11.1, J3.6, L1.1, U1.4
AVSS: C3.1, C5.2, C6.2, C12.1, U1.11, U2.5
GND: C10.2, J2.1, J3.1, J3.2
L_OUT_5: J2.2, J3.5
unnamed: C4.1, U2.2
unnamed: C4.2, U2.4
unnamed: C6.1, L1.2, U2.1, U2.8
unnamed: D1.1, R5.1, R7.2, U1.13
unnamed: D1.2, R6.1, R7.1
unnamed: D3.1, D4.1, R8.1, R10.2, R11.2, U1.6
unnamed: D3.2, U1.8
unnamed: D4.2, U1.7
unnamed: J1.2, R1.2
unnamed: R1.1, R12.1, U1.3
unnamed: R2.1, R8.2, U1.9
unnamed: R3.1, R6.2, U1.14
unnamed: R4.2, U1.1, U1.2
unnamed: R9.2, U1.5
unnamed: R10.1, U1.12
unnamed: R2.2, R4.1, R9.1, R13.1
VCC5: C10.1, J2.3, J3.7, J3.8
