kevinisabelle/litdlm01/PCBs/EC-DLM-001-Rev9/kicadProject/EC-DLM-001-Rev9.kicad_pcb

## KiCad design PCBs/EC-DLM-001-Rev9/kicadProject/EC-DLM-001-Rev9.kicad_pcb (2024-09-17)

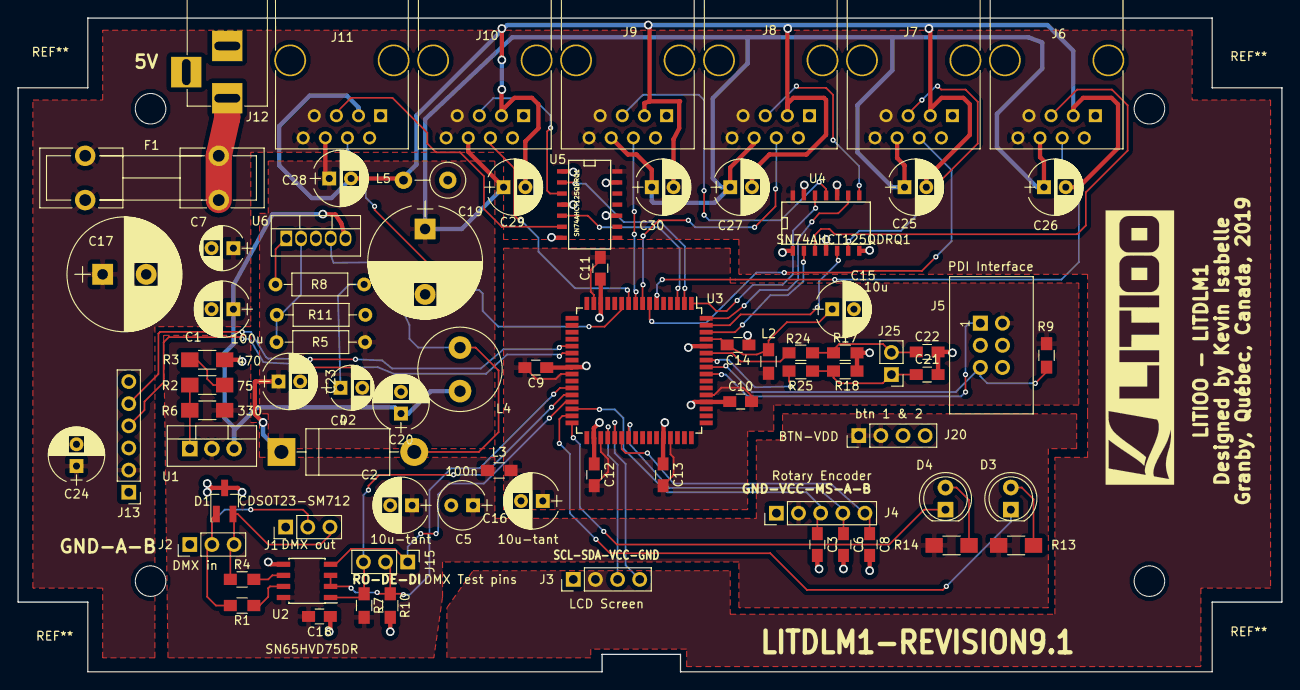
[picture p16: board EC-DLM-001-Rev9.kicad_pcb from above]

Board: 2 copper layers, 145.0 x 75.0 mm, 78 parts (0 on the bottom side), 56 nets.

Parts:
C1: 100u; CP_Radial_D6.3mm_P2.50mm
C2, C16: 10u-tant; CP_Radial_D6.3mm_P2.50mm
C3, C6, C8, C9, C10, C11, C12, C13, C14, C18, C21, C22: 100n; C_0805_HandSoldering
C4: 0.33u; CP_Radial_D5.0mm_P2.50mm
C5: 100n; CP_Radial_Tantal_D5.5mm_P2.50mm
C7: 0.1u; CP_Radial_D5.0mm_P2.50mm
C15: 10u; CP_Radial_D6.3mm_P2.50mm
C17: 1000u; CP_Radial_D13.0mm_P5.00mm
C19: 680u; CP_Radial_D13.0mm_P7.50mm
C20, C23, C24, C25, C26, C27, C28, C29, C30: 100n; CP_Radial_D6.3mm_P2.50mm
D1: CDSOT23-SM712; SOT-23_Handsoldering
D2: 1N5821; D_DO-201AD_P15.24mm_Horizontal
D3, D4: LED; LED_D5.0mm
F1: Fuse; Fuseholder5x20_horiz_open_lateral_Type-II
J1: DMX out; Pin_Header_Straight_1x03_Pitch2.54mm
J2: DMX in; Pin_Header_Straight_1x03_Pitch2.54mm
J3: LCD Screen; Pin_Header_Straight_1x04_Pitch2.54mm
J4: Rotary Encoder; Pin_Header_Straight_1x05_Pitch2.54mm
J5: PDI Interface; IDC_Header_Straight_6pins
J6, J7, J8, J9, J10, J11: RJ45; RJ45_8
J12: BARREL_JACK
J13: Bluetooth Module; Pin_Header_Straight_1x06_Pitch2.54mm
J15: DMX Test pins; Pin_Header_Straight_1x03_Pitch2.54mm
J20: BTN-VDD; Pin_Header_Straight_1x04_Pitch2.54mm
J25: btn 1 & 2; Pin_Header_Straight_1x02_Pitch2.54mm
L2: Fer Bead; L_0805_HandSoldering
L3: 10uH; L_0805_HandSoldering
L4: 100uH; L_Radial_D9.5mm_P5.00mm_Fastron_07HVP
L5: 10uH; L_Axial_L9.5mm_D4.0mm_P5.08mm_Vertical_Fastron_SMCC
R1, R4: 10; R_0805_HandSoldering
R2: 75; R_1206_HandSoldering
R3: 470; R_1206_HandSoldering
R5: 17.3k; R_Axial_DIN0207_L6.3mm_D2.5mm_P10.16mm_Horizontal
R6: 330; R_1206_HandSoldering
R7, R10, R17, R18: 10k; R_0805_HandSoldering
R8: 2.2k; R_Axial_DIN0207_L6.3mm_D2.5mm_P10.16mm_Horizontal
R9: 10K; R_0805_HandSoldering
R11: 2k; R_Axial_DIN0207_L6.3mm_D2.5mm_P10.16mm_Horizontal
R13, R14: R; R_1206_HandSoldering
R24, R25: 220; R_0805_HandSoldering
U1: LM317T; TO-220-3_Vertical
U2: SN65HVD75DR; SOIC-8_3.9x4.9mm_Pitch1.27mm
U3: ATXMEGA64A3U-AU; TQFP-64_14x14mm_Pitch0.8mm
U4, U5: SN74AHCT125QDRQ1; SOIC-14_N
U6: LM2577; TO-220-5_Vertical

Connections:
+5V: F1.2, J12.1
/MAX485-A: R1.1, U2.7
/MAX485-B: R4.2, U2.6
ADCTrig1: J6.4, U3.6
ADCTrig2: J7.4, U3.7
ADCTrig3: J8.4, U3.8
ADCTrig4: J9.4, U3.9
ADCTrig5: J10.4, U3.10
ADCTrig6: J11.4, U3.11
AVCC: C19.1, C23.1, C25.1, C26.1, C27.1, C28.1, C29.1, C30.1, D2.1, J6.6, J7.6, J8.6, J9.6, J10.6, J11.6, R5.2
AnalogGND: C25.2, C26.2, C27.2, C28.2, C29.2, C30.2, J6.3, J7.3, J8.3, J9.3, J10.3, J11.3, L5.2
BTN1: R25.2, U3.58
BTN2: R24.2, U3.59
BT_RX: J13.5, U3.21
BT_TX: J13.4, U3.22
DE-RE: J15.2, R10.1, U2.2, U2.3, U3.27
DI: J15.1, U2.4, U3.29
ENCODER_A: C8.1, J4.5, U3.38
ENCODER_B: C6.1, J4.4, U3.39
ENCODER_MS: C3.1, J4.3, U3.30
GND: C1.2, C2.2, C3.2, C4.2, C5.2, C6.2, C7.2, C8.2, C9.1, C10.1, C11.1, C12.1, C13.1, C14.1, C15.2, C16.2, C17.2, C18.1, C19.2, C20.2, C21.2, C22.2, C23.2, C24.2, D1.3, J1.1, J2.1, J3.1, J4.1, J5.6, J6.1, J6.2, J7.1, J7.2, J8.1, J8.2, J9.1, J9.2, J10.1, J10.2, J11.1, J11.2, J12.2, J12.3, J13.3, L5.1, R3.1, R10.2, R11.2, R17.2, R18.2, U2.5, U3.14, U3.24, U3.34, U3.44, U3.52, U3.60, U4.1, U4.4, U4.7, U4.10, U4.13, U5.1, U5.4, U5.7, U5.10, U5.13, U6.3
L1_OUT_3.3: U3.62, U4.2
L1_OUT_5: J6.5, U4.3
L2_OUT_3.3: U3.63, U4.5
L2_OUT_5: J7.5, U4.6
L3_OUT_3.3: U3.64, U4.9
L3_OUT_5: J8.5, U4.8
L4_OUT_3.3: U3.1, U4.12
L4_OUT_5: J9.5, U4.11
L5_OUT_3.3: U3.2, U5.2
L5_OUT_5: J10.5, U5.3
L6_OUT_3.3: U3.3, U5.5
L6_OUT_5: J11.5, U5.6
LCD_SCL: J3.4, U3.37
LCD_SDA: J3.3, U3.36
LED1: D3.1, U3.31
LED2: D4.1, U3.32
unnamed: C4.1, R8.2
unnamed: C14.2, C15.1, L2.2, U3.61
unnamed: C21.1, J25.1, R18.1, R25.1
unnamed: C22.1, J25.2, R17.1, R24.1
unnamed: D1.1, J1.2, J2.2, R1.2
unnamed: D1.2, J1.3, J2.3, R4.1
unnamed: D2.2, L4.1, U6.4
unnamed: D3.2, R13.1
unnamed: D4.2, R14.1
unnamed: R2.1, R6.2, U1.1
unnamed: R2.2, R3.2
unnamed: R8.1, U6.1
unnamed: R5.1, R11.1, U6.2
PDI_CLK: J5.5, R9.1, U3.57
PDI_DATA: J5.1, U3.56
RO: J15.3, R7.1, U2.1, U3.28
VCC: C1.1, C7.1, C17.1, C20.1, C24.1, F1.1, J3.2, J6.7, J6.8, J7.7, J7.8, J8.7, J8.8, J9.7, J9.8, J10.7, J10.8, J11.7, J11.8, J13.2, L4.2, U1.3, U4.14, U5.14, U6.5
VDD: C2.1, C5.1, C18.2, J4.2, J20.1, J20.2, L3.1, R6.1, R7.2, R13.2, R14.2, U1.2, U2.8
VDD-Filtered: C9.2, C10.2, C11.2, C12.2, C13.2, C16.1, J5.2, L2.1, L3.2, R9.2, U3.15, U3.25, U3.35, U3.45, U3.53
