kevinisabelle/litdlm01/PCBs/LITPS01/LITPS01.kicad_pcb

## KiCad design PCBs/LITPS01/LITPS01.kicad_pcb (2019-01-09)

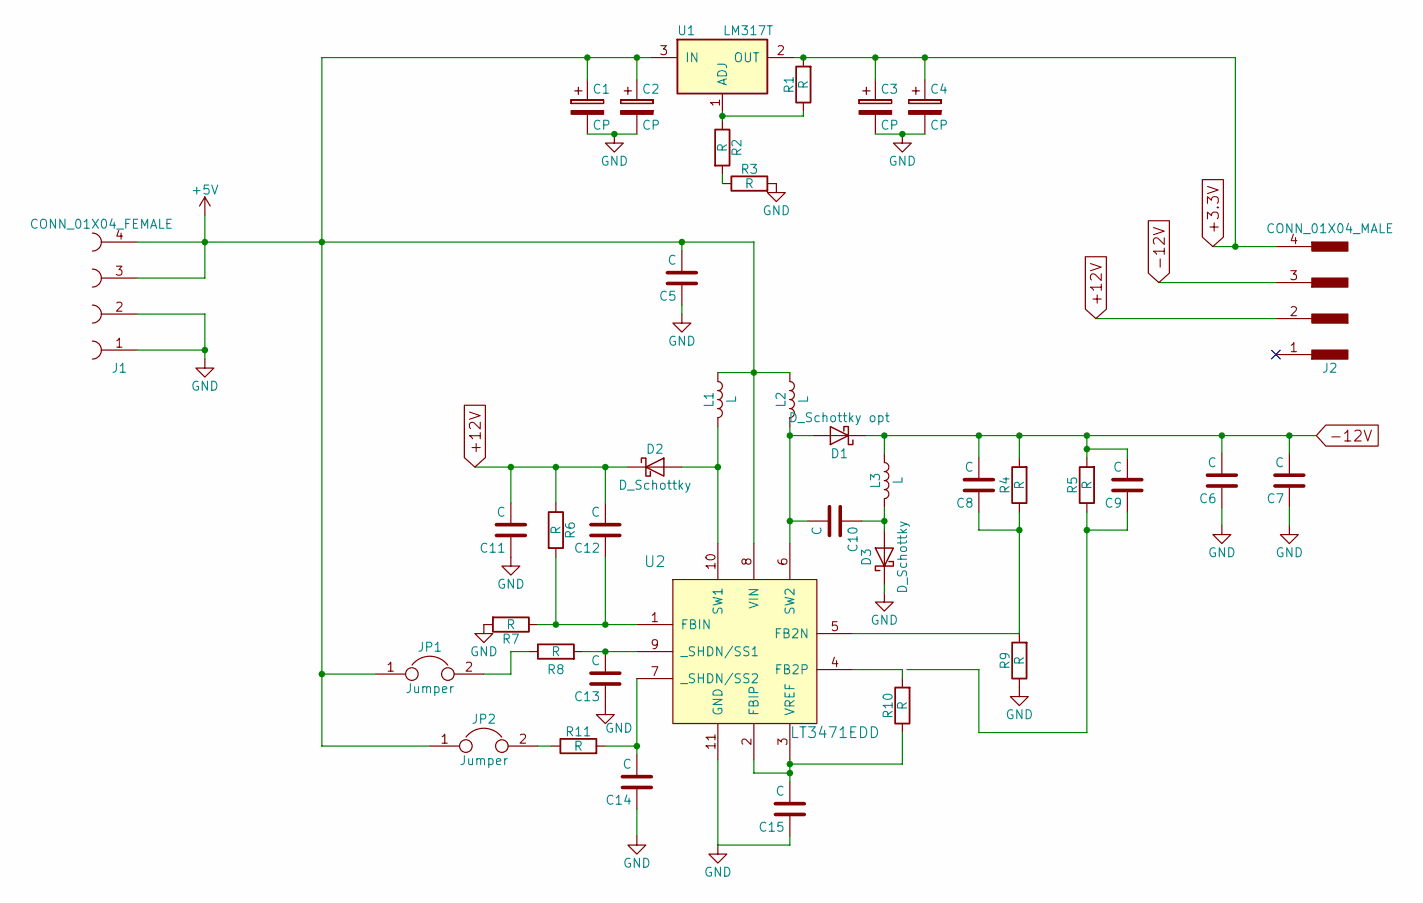
[picture p17: schematic LITPS01.sch, Multiple output power supply.]

Parts:
C1: CP; CP_Radial_D10.0mm_P5.00mm
C2, C3, C4: CP; CP_Radial_D5.0mm_P2.50mm
C5, C6, C7, C8, C9, C10, C11, C12, C13, C14, C15: C; C_1206_HandSoldering
D1: D_Schottky opt; D_PowerDI-123
D2, D3: D_Schottky; D_PowerDI-123
J1: CONN_01X04_FEMALE; Pin_Header_Straight_1x04_Pitch2.54mm
J2: CONN_01X04_MALE; Pin_Header_Straight_1x04_Pitch2.54mm
JP1, JP2: Jumper; Pin_Header_Straight_1x02_Pitch2.54mm
L1, L2, L3: L; Inductor_Taiyo-Yuden_NR-40xx_HandSoldering
R1, R2, R3, R4, R5, R6, R7, R8, R9, R10, R11: R; R_1206_HandSoldering
U1: LM317T; TO-220_Vertical
U2: LT3471EDD; DFN-10-1EP_3x3mm_Pitch0.5mm

Connections:
+3.3V: C3.1, C4.1, J2.4, R1.2, U1.2 (OUT)
+5V: C1.1, C2.1, C5.2, J1.3, J1.4, JP1.1, JP2.1, L1.1, L2.1, U1.3 (IN), U2.8 (VIN)
+12V: C11.2, C12.2, D2.1 (K), J2.2, R6.1
-12V: C6.2, C7.2, C8.2, C9.2, D1.1 (K), J2.3, L3.1, R4.2, R5.2
GND: C1.2, C2.2, C3.2, C4.2, C5.1, C6.1, C7.1, C11.1, C13.1, C14.1, C15.1, D3.1 (K), J1.1, J1.2, R3.2, R7.2, R9.1, U2.11 (GND)
unnamed: C8.1, R4.1, R9.2, U2.5 (FB2N)
unnamed: C9.1, R5.1
unnamed: C10.1, D3.2 (A), L3.2
unnamed: C10.2, D1.2 (A), L2.2, U2.6 (SW2)
unnamed: C12.1, R6.2, R7.1, U2.1 (FBIN)
unnamed: C13.2, R8.2, U2.9 (_SHDN/SS1)
unnamed: C14.2, R11.2, U2.7 (_SHDN/SS2)
unnamed: C15.2, R10.1, U2.2 (FBIP), U2.3 (VREF)
unnamed: D2.2 (A), L1.2, U2.10 (SW1)
unnamed: JP1.2, R8.1
unnamed: JP2.2, R11.1
unnamed: R1.1, R2.1, U1.1 (ADJ)
unnamed: R2.2, R3.1
unnamed: R10.2, U2.4 (FB2P)

Board: 2 copper layers, 37 parts (0 on the bottom side), 19 nets, no tracks yet.
