kevinisabelle/litdlm01/VSProject/ECDLM001/src/appbl.c

/*
 * appbl.c
 *
 * Created: 2017-07-22 21:58:02
 *  Author: Kevin
 */ 

#include "appbl.h"
#include "ws2812b.h"
#include "menu.h"
#include "asf.h"
#include "i2c_lcd.h"
#include <math.h>
#include <util/delay.h>
 #include <stdio.h>
 #include <stdlib.h>
 #include <string.h>

long ANIMATION_VALUES[NB_TRIGGERS] = {0};
int trig[NB_TRIGGERS] = {0};
unsigned char DISPLAY_PIXELS[NB_PIXELS] = {0};

// **Define the MIDI flags**
volatile uint8_t sendNoteOnFlag[NB_TRIGGERS] = {0};
volatile uint8_t sendNoteOffFlag[NB_TRIGGERS] = {0};
// **Define and initialize prev_ANIMATION_VALUES**
long prev_ANIMATION_VALUES[NB_TRIGGERS] = {0};

// **Define MIDI note mapping and settings**
uint8_t note_for_trigger[NB_TRIGGERS] = {60, 62, 64, 65, 67, 69}; // Adjust as needed
uint8_t midi_channel = 0;  // MIDI Channel 1
uint8_t velocity[NB_TRIGGERS] = {100, 100, 100, 100, 100, 100};    // Default velocity
	
const  unsigned char CURVE_LINEAR_ARR[256] =	{
	0,
	1,
	2,
	3,
	4,
	5,
	6,
	7,
	8,
	9,
	10,
	11,
	12,
	13,
	14,
	15,
	16,
	17,
	18,
	19,
	20,
	21,
	22,
	23,
	24,
	25,
	26,
	27,
	28,
	29,
	30,
	31,
	32,
	33,
	34,
	35,
	36,
	37,
	38,
	39,
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

};
const unsigned char CURVE_EXP_ARR[256] =		{
	0,
	0,
	0,
	0,
	0,
	0,
	0,
	0,
	0,
	0,
	0,
	0,
	0,
	0,
	0,
	0,
	0,
	0,
	0,
	0,
	0,
	0,
	0,
	0,
	0,
	0,
	0,
	0,
	0,
	0,
	0,
	0,
	0,
	0,
	0,
	0,
	0,
	0,
	0,
	0,
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

};
const unsigned char CURVE_LOG_ARR[256] =		{
	0,
	0,
	32,
	51,
	64,
	74,
	82,
	90,
	96,
	101,
	106,
	110,
	114,
	118,
	121,
	125,
	128,
	130,
	133,
	136,
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
	
	{0,0,0,0,0,0,0,0,0,0},
	{1,0,0,0,0,0,0,0,0,2},
	{0,1,0,0,0,0,0,0,2,0},
	{0,0,1,0,0,0,0,2,0,0},
	{0,0,0,1,0,0,2,0,0,0},
	{0,0,0,0,1,2,0,0,0,0},
	{0,0,0,0,2,1,0,0,0,0},
	{0,0,0,2,0,0,1,0,0,0},
	{0,0,2,0,0,0,0,1,0,0},
	{0,2,0,0,0,0,0,0,1,0},
	{2,0,0,0,0,0,0,0,0,1}
};

// Animation definition: Center Fixed EQ
uint8_t		A_CFIXEDEQ_SMOOTH = 1;
unsigned int 	A_CFIXEDEQ_STATE_SIZE = 6;
char	A_CFIXEDEQ_ARR[7][10] = {
	
	{0, 0, 0, 0, 0, 0, 0, 0, 0, 0}, //  0
	{0, 0, 0, 0, 1, 0, 0, 0, 0, 0}, //  1
	{0, 0, 0, 1, 1, 1, 0, 0, 0, 0}, //  2
	{0, 0, 1, 1, 1, 1, 1, 0, 0, 0}, //  3
	{0, 2, 1, 1, 1, 1, 1, 2, 0, 0}, //  4
	{2, 2, 1, 1, 1, 1, 1, 2, 2, 0}, //  5
	{2, 2, 1, 1, 1, 1, 1, 2, 2, 2}, //  6
};


inline int getOffset(int triggerIndex){

	switch (triggerIndex){

		case 0:
			return 0;
		case 1:
			return nbPixels1;
		case 2:
			return nbPixels1 + nbPixels2;
		case 3:
			return nbPixels1 + nbPixels2 + nbPixels3;
		case 4:
			return nbPixels1 + nbPixels2 + nbPixels3 + nbPixels4;
		case 5:
			return nbPixels1 + nbPixels2 + nbPixels3 + nbPixels4 + nbPixels5;

	}

	return 0;

}

inline int getNbPixels(int triggerIndex){

	switch (triggerIndex){

		case 0:
			return nbPixels1;
		case 1:
			return nbPixels2;
		case 2:
			return nbPixels3;
		case 3:
			return nbPixels4;
		case 4:
			return nbPixels5;
		case 5:
			return nbPixels6;
	}

	return 0;
}

inline unsigned int clipValue(long value, int index){
	
	unsigned int inputSens = 0;
	
	switch(index){
		case 0:
			inputSens = inputSens1;
			break;
			
		case 1:
			inputSens = inputSens2;
			break;
			
		case 2:
			inputSens = inputSens3;
			break;
			
		case 3:
			inputSens = inputSens4;
			break;
			
		case 4:
			inputSens = inputSens5;
			break;
			
		case 5:
			inputSens = inputSens6;
			break;
	}
	
	value = value + inputSens;
	
	/*if (value > 30) {
		value = value - 30;
	}*/
	
	if (value < 100){
		value = 0;
	} 
	
	if (value > 255){
		value = 255;
	}
	
	unsigned long retValue = value << 8; // Max at this stage is 65535
	
	if (retValue < 0){
		retValue = 0;
	}
	
	if (retValue > 65535){
		retValue = 65535;
	}
	
	return retValue;
}

inline unsigned int getAnimationValue(unsigned int trigValue, unsigned int currentAnimationValue, int i){
	
	unsigned int releaseValue = (101 - release) << 6;
		
	if (currentAnimationValue <= releaseValue){
		currentAnimationValue = 0;
	} else {
		currentAnimationValue -= releaseValue;
	}

	if (currentAnimationValue < 0){
		currentAnimationValue = 0;
	}
	
	return currentAnimationValue;
}

inline void updateSinglePixel(int offset, int r, int g, int b){
	DISPLAY_PIXELS[offset] = r;
	DISPLAY_PIXELS[offset+1] = g;
	DISPLAY_PIXELS[offset+2] = b;
}

void updatePixels(unsigned int animationValue, int triggerIndex){
	
	unsigned int displayValue = 0;

	unsigned int animPosition = animationValue >> SCALE_FACTOR_BITS;
	unsigned int indexCurve = animPosition; // 0-4096 => 0 - 255
	unsigned int value1 = 0;
		
	switch (releaseCurve){
		
		case 0:
			value1 =  ((CURVE_LINEAR_ARR[indexCurve]));
			break;
			
		case 1:
			value1 = ((CURVE_EXP_ARR[indexCurve]));
			break;
			
		case 2:
			value1 = ((CURVE_LOG_ARR[indexCurve]));
			break;
			
		case 3:
			value1 = (CURVE_SINFADE_ARR[indexCurve]);
			break;
	} 
	
	displayValue = value1;
	
	if (animationTrigger == ANIM_TRIG_OFF){
		displayValue = 0;
	}

	if (animationTrigger == ANIM_TRIG_ON){
		displayValue = 255;
	}
	
	int offset = getOffset(triggerIndex) * 3;

	unsigned int  numberOfFrames = 1;
	uint8_t smooth = 0;
	char (*animData)[10]  = NULL;
	
	switch (animation){
	
			case ANIMATION_PULSE:
				numberOfFrames = A_PULSE_STATE_SIZE;
				smooth = A_PULSE_SMOOTH;
				animData = A_PULSE_ARR;
				break;
				
			case ANIMATION_PULSE_S:
				numberOfFrames = A_PULSES_STATE_SIZE;
				smooth = A_PULSES_SMOOTH;
				animData = A_PULSES_ARR;
				break;
				
			case ANIMATION_PULSE_C:
				numberOfFrames = A_PULSEC_STATE_SIZE;
				smooth = A_PULSEC_SMOOTH;
				animData = A_PULSEC_ARR;
				break;
				
			case ANIMATION_FILL:
				numberOfFrames = A_FILLL_STATE_SIZE;
				smooth = A_FILLL_SMOOTH;
				animData = A_FILLL_ARR;
				break;
				
			case ANIMATION_CFILL:
				numberOfFrames = A_FILLCENTER_STATE_SIZE;
				smooth = A_FILLCENTER_SMOOTH;
				animData = A_FILLCENTER_ARR;
				break;
				
			case ANIMATION_EQMOV:
				numberOfFrames = A_MOVINGEQ_STATE_SIZE;
				smooth = A_MOVINGEQ_SMOOTH;
				animData = A_MOVINGEQ_ARR;
				break;
				
			case ANIMATION_EQFIXED:
				numberOfFrames = A_FIXEDEQ_STATE_SIZE;
				smooth = A_FIXEDEQ_SMOOTH;
				animData = A_FIXEDEQ_ARR;
				break;
				
			case ANIMATION_CEQMOV:
				numberOfFrames = A_CMOVINGEQ_STATE_SIZE;
				smooth = A_CMOVINGEQ_SMOOTH;
				animData = A_CMOVINGEQR_ARR;
				break;
				
			case ANIMATION_CEQFIXED:
				numberOfFrames = A_CFIXEDEQ_STATE_SIZE;
				smooth = A_CFIXEDEQ_SMOOTH;
				animData = A_CFIXEDEQ_ARR;
				break;
	}
	
	// Choose the 2 rows of data from animation that match
	unsigned int frameValue8Bits = (SCALE_FACTOR) / numberOfFrames;
	unsigned int position8Bits = (displayValue);
	unsigned int frameIndex = position8Bits / frameValue8Bits; //
	unsigned int frameRatio8bits = (position8Bits % frameValue8Bits) * SCALE_FACTOR / frameValue8Bits;

	char* animFrame1 = &(animData[frameIndex]);//&(animData[frameIndex == 0 ? frameIndex : frameIndex -1]);
	char* animFrame2 = &(animData[frameIndex == numberOfFrames ? frameIndex : frameIndex + 1]);
	
	int colorsR[3] = {0, (int)colorR1, (int)colorR2};
	int colorsG[3] = {0, (int)colorG1, (int)colorG2};
	int colorsB[3] = {0, (int)colorB1, (int)colorB2};
	
	for (int i=0; i<getNbPixels(triggerIndex); i++){
			
		// TODO: Remove float
		float indexPixelComplete = ((float)i * ((9.0f/getNbPixels((triggerIndex)))));
		int indexPixel = floor(indexPixelComplete);
		
		int color1 = animFrame1[indexPixel];
		int color2 = animFrame2[indexPixel];
		
		unsigned int r = 0;
		unsigned int g = 0;
		unsigned int b = 0;
		
		if (smooth == 1){

			r = (((frameRatio8bits * colorsR[color2]) >> SCALE_FACTOR_BITS) + (((SCALE_FACTOR - frameRatio8bits) * colorsR[color1]) >> SCALE_FACTOR_BITS));
			g = (((frameRatio8bits * colorsG[color2]) >> SCALE_FACTOR_BITS) + (((SCALE_FACTOR - frameRatio8bits) * colorsG[color1]) >> SCALE_FACTOR_BITS));
			b = (((frameRatio8bits * colorsB[color2]) >> SCALE_FACTOR_BITS) + (((SCALE_FACTOR - frameRatio8bits) * colorsB[color1]) >> SCALE_FACTOR_BITS));
			
		} else {

			r = colorsR[color2];
			g = colorsG[color2];
			b = colorsB[color2];
		}
		
		updateSinglePixel(offset+i*3, (r * dimmer) >> SCALE_FACTOR_BITS, (g * dimmer) >> SCALE_FACTOR_BITS, (b * dimmer) >> SCALE_FACTOR_BITS);		
	}		
}


int counterEdit = 0;

ISR(LED_REFRESH) {
	
	for (uint8_t strip=0; strip<NB_TRIGGERS; strip++){
		
		uint8_t stripPin = 1 << strip;
		//cli();
		for (uint8_t i=0; i<getNbPixels(strip); i++){
			int pos = getOffset(strip) * 3;
			
			sendPixel(
				DISPLAY_PIXELS[pos+(i*3)], 
				DISPLAY_PIXELS[pos+(i*3)+1], 
				DISPLAY_PIXELS[pos+(i*3)+2], 
				stripPin);
		}
		//sei();
	}
}

short direction[6]  = {0, 0, 0, 0, 0, 0};

int speedCoeficient = (1 << 8);

ISR(ANIM_REFRESH) {
	
	if (editingValue){
		return;
	}
	
	for (int i=0; i<NB_TRIGGERS;i++) {

		switch (animationTrigger) {

			case ANIM_TRIG_ON:
				TRIGGER_STATES[i] = 65535;
				break;

			case ANIM_TRIG_OFF:
				TRIGGER_STATES[i] = 0;
				break;

			case ANIM_TRIG_AUTOALL:
			case ANIM_TRIG_AUTOSINGLE:
				
				if (direction[i] == 0){
					ANIMATION_VALUES[i] += (speedCoeficient * (101-release));

					if (ANIMATION_VALUES[i] >= 65535){
						direction[i] = 1;
						ANIMATION_VALUES[i] = 65535;
					}

					} else {
						
						ANIMATION_VALUES[i] -= (speedCoeficient * (101-release));

					if (ANIMATION_VALUES[i] <= 0){
						direction[i] = 0;
						ANIMATION_VALUES[i] = 0;
					}
				}
			
				break;

			case ANIM_TRIG_RNDSINGLE:
			case ANIM_TRIG_RNDALL:
				ANIMATION_VALUES[i] = rand();
				break;

			case ANIM_TRIG_TRIGGER:
				ANIMATION_VALUES[i] = getAnimationValue(TRIGGER_STATES[i] , ANIMATION_VALUES[i], i); //Get the conversion result
				break;
		}

		
		updatePixels(ANIMATION_VALUES[i], i);
	}
}
