kevinisabelle/litdlm01/(commit log)

2019-02-17 Working on DLM pcb rev9
    [EC-DLM-001-Rev9.sch]
2019-02-18 TR04 + DLM01 REV9 adjustments.
    [DLM-Enclosure.kicad_pcb, DLM-Enclosure.sch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]
2019-02-28 New Main board.
    [EC-DLM-001-Rev9.csv, EC-DLM-001-Rev9.kicad_pcb, EC-DLM-001-Rev9.ods, EC-DLM-001-Rev9.sch, ec-dlm-tr04.sch]
2019-03-03 Revision board rev9
    [EC-DLM-001-Rev9.kicad_pcb, EC-DLM-001-Rev9.sch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]
2019-03-05 New board pour production
    [EC-DLM-001-Rev9-B.Cu.gbl, EC-DLM-001-Rev9-B.Mask.gbs, EC-DLM-001-Rev9-B.Paste.gbp, EC-DLM-001-Rev9-B.SilkS.gbo, EC-DLM-001-Rev9-Edge.Cuts.gm1, EC-DLM-001-Rev9-F.Cu.gtl, EC-DLM-001-Rev9-F.Mask.gts, EC-DLM-001-Rev9-F.Paste.gtp]
2019-03-28 PCB Rouge
    [EC-DLM-001-Rev9-B.Cu.gbl, EC-DLM-001-Rev9-B.Mask.gbs, EC-DLM-001-Rev9-B.Paste.gbp, EC-DLM-001-Rev9-B.SilkS.gbo, EC-DLM-001-Rev9-Edge.Cuts.gm1, EC-DLM-001-Rev9-F.Cu.gtl, EC-DLM-001-Rev9-F.Mask.gts, EC-DLM-001-Rev9-F.Paste.gtp]
2019-08-29 Revision TR05 (Board rouge satellite) selon les tests.
    [ec-dlm-tr04-bom.csv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]
2019-11-28 Fixed screen corruption problem.
    [EC-DLM-001-Rev9-B.Cu.gbl, EC-DLM-001-Rev9-B.Mask.gbs, EC-DLM-001-Rev9-B.Paste.gbp, EC-DLM-001-Rev9-B.SilkS.gbo, EC-DLM-001-Rev9-Edge.Cuts.gm1, EC-DLM-001-Rev9-F.Cu.gtl, EC-DLM-001-Rev9-F.Mask.gts, EC-DLM-001-Rev9-F.Paste.gtp]
2019-12-11 Fix pour les lumières internes ainsi que le bouton qui ne réagissait pas bien
    [main.c, menu.c]
2023-01-07 Updates for ADC
2024-09-17 midi support
    [EC-DLM-001-Rev9-2022-12-05-00-30-45.sch, EC-DLM-001-Rev9.kicad_pcb, EC-DLM-001-Rev9.kicad_sch, ec-dlm-tr04-2023-01-07-00-39-24.sch, ec-dlm-tr04.kicad_pcb, ec-dlm-tr04.kicad_sch]
